the-ercules/Pantry-Lights/PantryLights/PantryLights.kicad_pcb

## KiCad design PantryLights/PantryLights.kicad_pcb (2022-05-29)

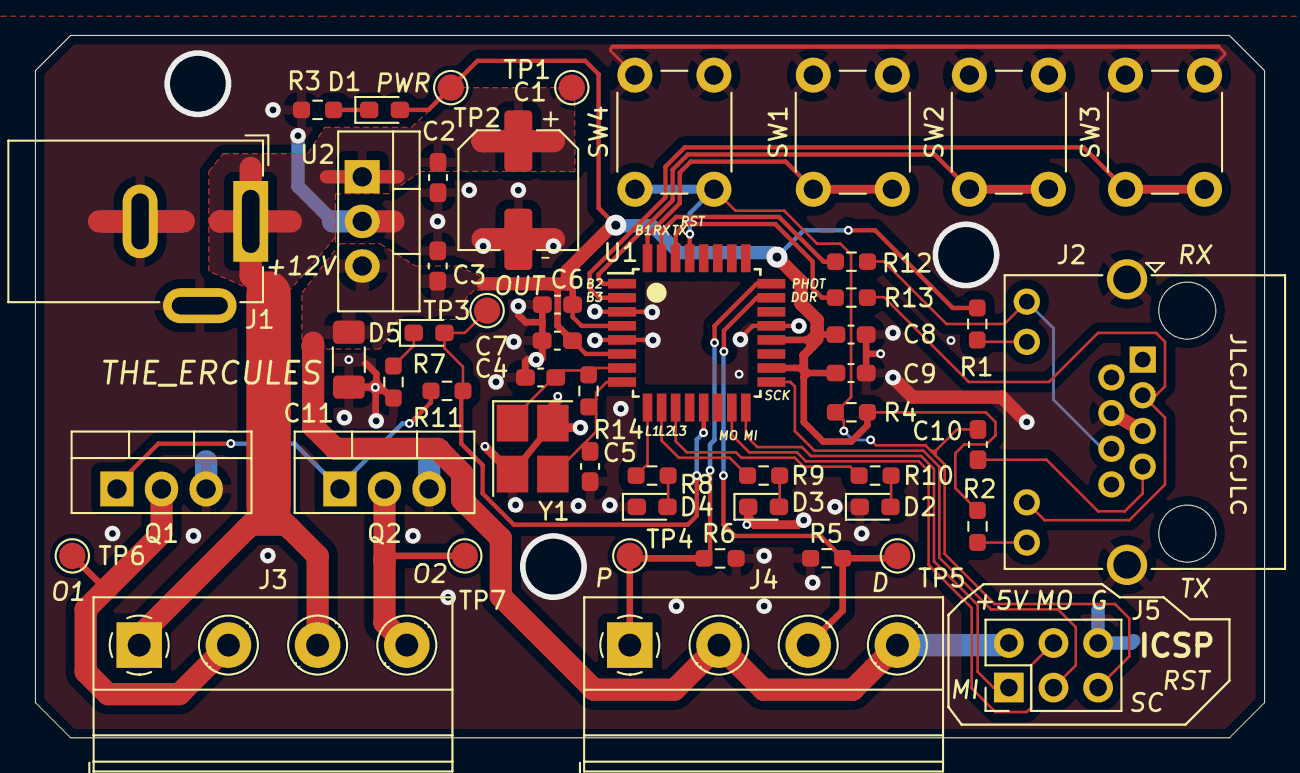
[picture p1: board PantryLights.kicad_pcb from above]

Board: 2 copper layers, 70.0 x 40.0 mm, 51 parts (0 on the bottom side), 33 nets.

Parts:
C1: 22u; CP_Elec_6.3x5.9
C2, C3, C6, C7, C8, C9, C10: 100n; C_0603_1608Metric_Pad1.08x0.95mm_HandSolder
C4, C5: 18p; C_0603_1608Metric_Pad1.08x0.95mm_HandSolder
C11: 4.7u; C_1206_3216Metric_Pad1.33x1.80mm_HandSolder
D1, D5: RED; LED_0603_1608Metric_Pad1.05x0.95mm_HandSolder
D2, D3, D4: GREEN; LED_0603_1608Metric_Pad1.05x0.95mm_HandSolder
J1: Barrel_Jack_Switch; BarrelJack_GCT_DCJ200-10-A_Horizontal
J2: 8P8C_LED_Shielded; RJ45_Amphenol_RJHSE538X
J3, J4: Conn_01x04; TerminalBlock_Right-Angle_Modular-1,5-4-5.08_1x04_P5.08mm_H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
J5: Conn_02x03_Counter_Clockwise; PinHeader_2x03_P2.54mm_Vertical
Q1, Q2: IRF540N; TO-220-3_Vertical
R1, R2: 150R; R_0603_1608Metric_Pad0.98x0.95mm_HandSolder
R3, R7: 750R; R_0603_1608Metric_Pad0.98x0.95mm_HandSolder
R4, R5: 10K; R_0603_1608Metric_Pad0.98x0.95mm_HandSolder
R6: 5K; R_0603_1608Metric_Pad0.98x0.95mm_HandSolder
R8, R9, R10: 600R; R_0603_1608Metric_Pad0.98x0.95mm_HandSolder
R11: 220R; R_0603_1608Metric_Pad0.98x0.95mm_HandSolder
R12, R13: 1K; R_0603_1608Metric_Pad0.98x0.95mm_HandSolder
R14: 1M; R_0603_1608Metric_Pad0.98x0.95mm_HandSolder
SW1, SW2, SW3, SW4: SW_MEC_5E; SW_PUSH_6mm_H5mm_4pin
TP1, TP2, TP3, TP4, TP5, TP6, TP7: TestPoint; TestPoint_Pad_D1.5mm
U1: ATmega328P-A; TQFP-32_7x7mm_P0.8mm
U2: LM7805_TO220; TO-220-3_Vertical
Y1: 16MHz; Crystal_SMD_3225-4Pin_3.2x2.5mm_HandSoldering

Connections:
+5V: C3.1, C6.1, C7.1, C8.2, C9.2, C11.1, D1.2 (A), J4.2, J4.4, J5.2, R1.1, R2.1, R4.2, TP2.1, U1.4 (VCC), U1.6 (VCC), U1.18 (AVCC), U1.20 (AREF), U2.3 (VO)
+12V: C1.1, C2.1, J1.1, J3.1, J3.3, TP1.1, U2.1 (VI)
/BTN_1: SW1.1, SW1.2, U1.32 (PD2)
/BTN_2: SW2.1, SW2.2, U1.1 (PD3)
/BTN_3: SW3.1, SW3.2, U1.2 (PD4)
/DOOR_SW_IN: J4.3, R5.2, TP5.1, U1.23 (PC0)
/LED_1: R8.1, U1.9 (PD5)
/LED_2: R9.1, U1.10 (PD6)
/LED_3: R10.1, U1.11 (PD7)
/LIGHTS_CL: Q1.1 (G), Q2.1 (G), R11.2
/LIGHT_SIGNAL: D5.2 (A), R11.1, TP3.1, U1.13 (PB1)
/OSC_A: C4.2, R14.2, U1.7 (XTAL1/PB6), Y1.1
/OSC_B: C5.2, R14.1, U1.8 (XTAL2/PB7), Y1.3
/PHOTORESISTOR_IN: J4.1, R6.1, TP4.1, U1.24 (PC1)
GND: C1.2, C2.2, C3.2, C4.1, C5.1, C6.2, C7.2, C8.1, C9.1, C11.2, D2.1 (K), D3.1 (K), D4.1 (K), J1.2, J1.3, J2.4, J2.5, J2.SH, J5.6, Q1.3 (S), Q2.3 (S), R3.2, R5.1, R6.2, R7.2, SW1.3 (K), SW1.4 (A), SW2.3 (K), SW2.4 (A), SW3.3 (K), SW3.4 (A), SW4.1, SW4.2, U1.3 (GND), U1.5 (GND), U1.21 (GND), U2.2 (GND), Y1.2, Y1.4
MISO: J5.1, U1.16 (PB4)
MOSI: J5.4, U1.15 (PB3)
unnamed: C10.1, J2.7
unnamed: D1.1 (K), R3.1
unnamed: D5.1 (K), R7.1
unnamed: J2.6, J2.9, R12.2
unnamed: J2.10, R1.2
unnamed: J2.3, J2.11, R13.2
unnamed: J2.12, R2.2
unnamed: J3.2, Q1.2 (D), TP6.1
unnamed: J3.4, Q2.2 (D), TP7.1
unnamed: D4.2 (A), R8.2
unnamed: D3.2 (A), R9.2
unnamed: D2.2 (A), R10.2
RESET: C10.2, J5.5, R4.1, SW4.3 (K), SW4.4 (A), U1.29 (~RESET/PC6)
RX: R12.1, U1.31 (PD1)
SCK: J5.3, U1.17 (PB5)
TX: R13.1, U1.30 (PD0)
