the-ercules/Pantry-Lights/(commit log)

2022-01-11 Initial Working Code
    This version works on the bench with the minimum feature-set, but is not quite ready for beta.
    TODO:
    - EEPROM integration
    - menu timeout (no save)
    - menu interface changes (maybe dedicated LED?)
    - Remove serial debugging output
2022-01-12 Beta-Ready
    REV 0.2.2 : Beta
    Software is now where I want it to be. Fully user configurable, with EEPROM to save important values. Also added panic mode to load factory defaults into ram (Can lock in by skipping through all settings menus)
    Decided not to add additional output LED since the main lights are a good enough interface
    Added menu timeout, we'll see if 5 mins is long enough.
    Framework for debugging is there, but not quite good. Maybe add a debugging option in the settings menu in the future?
    [Pantry-Lights.ino, led_control.cpp]
2022-01-15 Updating for actual prototype
    Changed buttons, added more debug data, and added local copies of dependencies.
2022-01-20 Schematic and prelim PCB layout
    [PantryLights.kicad_pcb, PantryLights.kicad_sch]
2022-01-27 Added Gerbers per REV_1
    [PantryLights-B_Mask.gbr, PantryLights-B_Paste.gbr, PantryLights-B_Silkscreen.gbr, PantryLights-Back.gbr, PantryLights-Edge_Cuts.gbr, PantryLights-F_Mask.gbr, PantryLights-F_Paste.gbr, PantryLights-F_Silkscreen.gbr]
2022-02-18 Second PCB Revision
    [PantryLights.kicad_pcb]
2022-05-29 Board Order
    [PantryLights-B_Cu.gbl, PantryLights-B_Mask.gbs, PantryLights-B_Paste.gbp, PantryLights-B_Silkscreen.gbo, PantryLights-Edge_Cuts.gm1, PantryLights-F_Cu.gtl, PantryLights-F_Mask.gts, PantryLights-F_Paste.gtp]
